bilodeau/ECE477PROJECTS/docs/FinalReport.tex

% just setup stuff
\documentclass[12pt]{article}

% Alter some LaTeX defaults for better treatment of figures:
    % See p.105 of "TeX Unbound" for suggested values.
    % See pp. 199-200 of Lamport's "LaTeX" book for details.
    %   General parameters, for ALL pages:
    \renewcommand{\topfraction}{0.9}	% max fraction of floats at top
    \renewcommand{\bottomfraction}{0.8}	% max fraction of floats at bottom
    %   Parameters for TEXT pages (not float pages):
    \setcounter{topnumber}{2}
    \setcounter{bottomnumber}{2}
    \setcounter{totalnumber}{4}     % 2 may work better
    \setcounter{dbltopnumber}{2}    % for 2-column pages
    \renewcommand{\dbltopfraction}{0.9}	% fit big float above 2-col. text
    \renewcommand{\textfraction}{0.07}	% allow minimal text w. figs
    %   Parameters for FLOAT pages (not text pages):
    \renewcommand{\floatpagefraction}{0.7}	% require fuller float pages
	% N.B.: floatpagefraction MUST be less than topfraction !!
    \renewcommand{\dblfloatpagefraction}{0.7}	% require fuller float pages

	% remember to use [htp] or [htpb] for placement

% style, margins, etc...
\usepackage[left=0.5in,top=1.5in,right=0.5in,bottom=1.5in]{geometry}
\usepackage{graphicx}
\usepackage{amsmath}
\usepackage{listings}
	\lstset{language = C}
\usepackage{url}
% all figures are stored in the subdir "figs"
\graphicspath{{./figs/}}

\newcommand{\tab}{\hspace*{2em}}

% define the title and author(s)
\author{Peter Bilodeau\\
	peterjbilodeau@gmail.com\and
	Brady Butler\\
	m.brady.butler@gmail.com\and
	Breanna Stanaway\and
	Cody Morgan\\
	}
\title{ECE 477 Final Project}

\begin{document}

%--------------------------------------------------------------------------
% generates the title
\maketitle

% abstract
\begin{abstract}
For this project, we designed and built an autonomous flying quadrotor.  Our design anticipates automatic stability control and navigation. This project lays the foundation for integrated sensor and motor control systems.
We built a custom aluminum frame and a custom electronic main board, and use stock hobby motors, propellers and lithium-polymer battery.
\end{abstract}
\clearpage

% start a new page
\clearpage

% generates the table of contents
%(need to run latex twice for this to get updated)
\tableofcontents

% start a new page
\clearpage

%--------------------------------------------------------------------------
% The Actual Paper

\input{flightdynamics}

\input{systemarchitecture}

\clearpage
\input{motorcontrol}

\clearpage
\input{power}

\input{communication}

\input{sensors}

\input{filtering}

\input{i2c}

\input{pidcontrollers}

\input{mastercontrol}

\clearpage
\input{pcside}

\clearpage
\input{partslist}

\clearpage
\input{schematics}

\clearpage
\input{code}

% The End
\end{document}
