bilodeau/ECE477PROJECTS/docs/schematics.tex

\section{Schematics}
\begin{figure}[htb]
\begin{center}
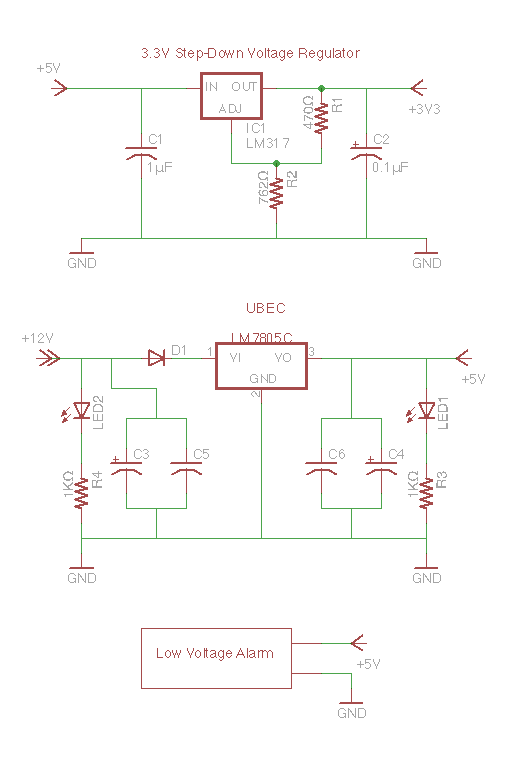
[picture p1: docs/powerschem.png]

\caption{Power Conversion Circuits}
\end{center}
\end{figure}

\begin{figure}[htb]
\begin{center}
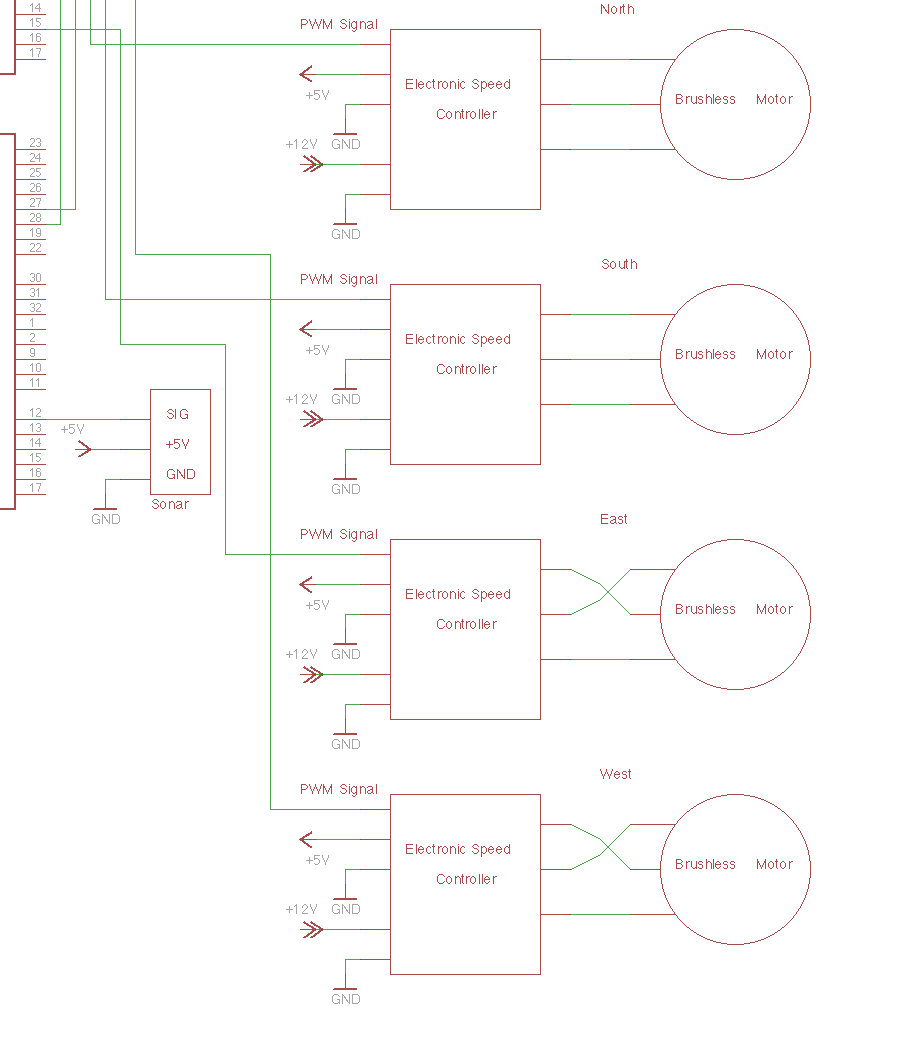
[picture p2: docs/motorsschem.png]

\caption{Motor Connections}
\end{center}
\end{figure}

\begin{figure}[htb]
\begin{center}
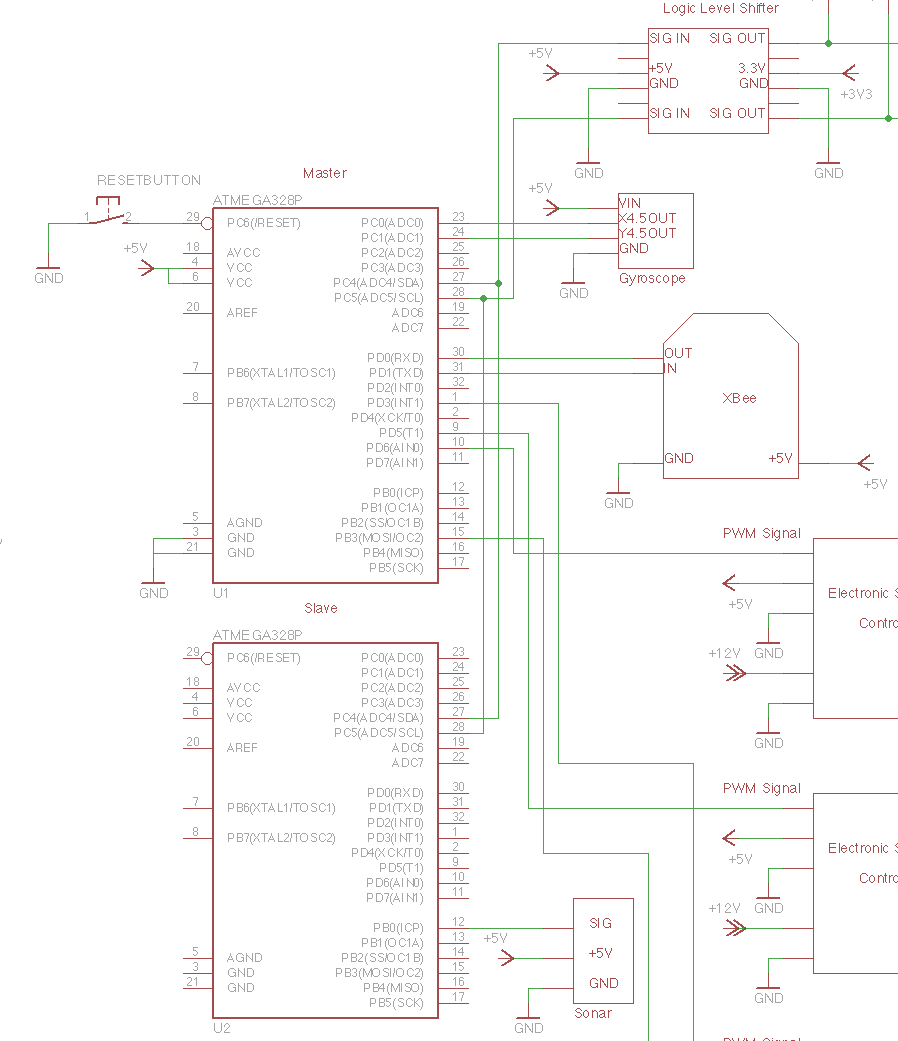
[picture p3: docs/masterslaveschem.png]

\caption{AVR Microcontroller Connections}
\end{center}
\end{figure}

\begin{figure}[htb]
\begin{center}
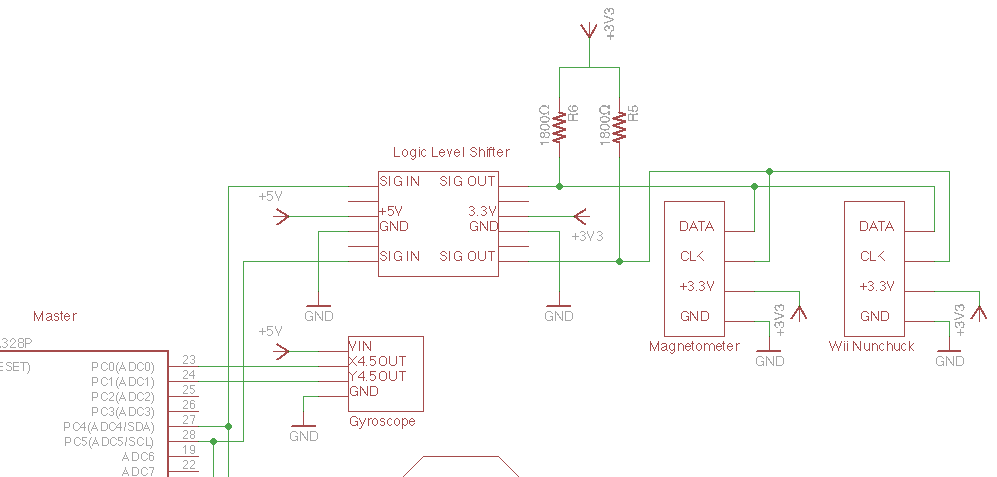
[picture p4: docs/i2cbusschem.png]

\caption{$I^2C$ Bus Circuit} 
\end{center}
\end{figure}
