bilodeau/ECE477PROJECTS/docs/partslist.tex

\section{Parts List}
\setcounter{table}{0}
\renewcommand*\thetable{\Alph{section}.\arabic{table}}
\begin{table}[htpb]
\begin{center}
\caption{Parts List}
\begin{tabular}{|l|l|r|r|}
\hline

Part & Make and Model & Quantity &Estimated Cost\\ \hline \hline 
Frame & 3/4" square aluminum tubing & 2 x 55cm & \$14.00\\ \hline
Motor &	Hextronik DT700 & 4 & 43.88\\ \hline
Propeller & 10x6 HCB & 4 & 3.48\\ \hline
Prop Saver & 4mm w/ Band & 4 & 4.18\\ \hline
ESC & HobbyWing Fly-Fun 18A Brushless ESC & 4 & 79.99\\ \hline
Battery & ZIPPY Flightmax 3000mAh 3S1P 20C & 1 & 12.99\\ \hline
Voltage Detector & Tunigy 3~8S Voltage Detector & 1 & 2.49\\ \hline
Power Distributer & custom & 1 & -\\ \hline
Sonar Sensor & Parallax Ping))) Ultrasonic & 1 & 29.99\\ \hline
Accelerometer & Wii Nunchuck & 1 & 19.99\\ \hline
Gyroscope & IDG500 Dual 500/s breakout & 1 & 39.95\\ \hline
Magnetometer & 3-Axis HMC5883L breakout & 1 & 14.95\\ \hline
UBEC & custom & 1 & -\\ \hline
5v to 3.3v converter & custom & 1 & -\\ \hline
Logic Level Converter & 1.8 to 5V range, BOB-08745& 1 & 1.95\\ \hline
Master / Slave controller & ATmega 328p & 2 & 9.90\\ \hline
XBee &  & 2 & 49.90\\ \hline
XBee adapter board & XBee to Serial & 2 & 33.90\\ \hline
Serial Port Adapter & Sheaf-Monk Utility Board & 1 & 10.00\\ \hline
Reset Button & Basic default-off push-buton & 1 & 0.50\\ \hline \hline
Total:&&& \$372.04\\ \hline
\end{tabular}
\end{center}
\end{table}
