bilodeau/ECE477PROJECTS/docs/TODO.txt

This document is intended to list the sections of the document which remain to be completed.

Breanna / Cody, I wasn't sure if you wanted your email addresses added to the cover page.  You can add them to FinalReport.tex if you want.

File that need writing:
FinalReport
mastercontrol
discussion
conclusion

Files completed up to proofreading or minor edits:
filtering
sensors
flightdynamics
systemarchitecture
motorcontrol
power
communication
I2C Bus
pidcontrollers
pcside
schematics
code
partslist
