bilodeau/ECE477PROJECTS/battleship/Serial.sch

## EAGLE design battleship/Serial.sch (2012-02-24, last stored version)

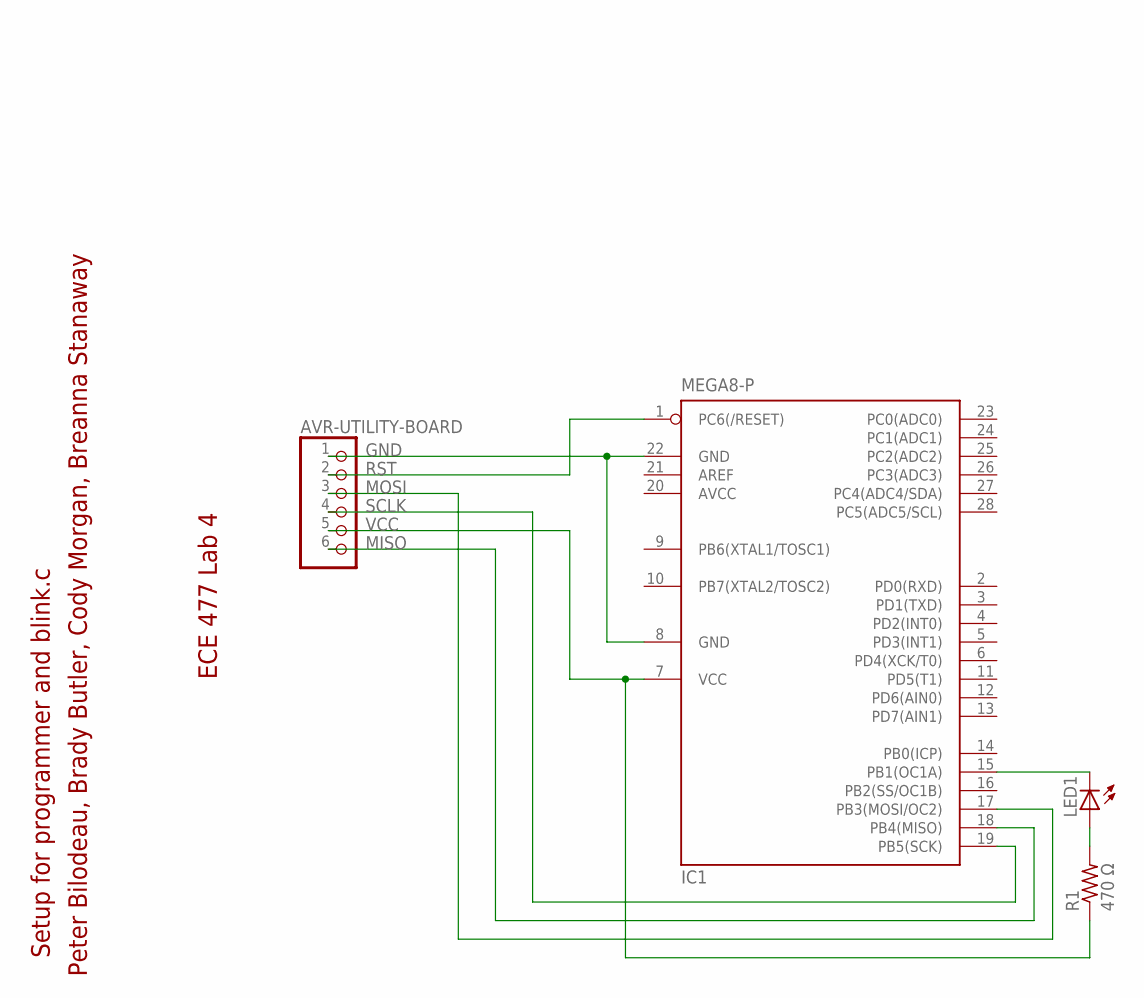
[picture p6: schematic Serial.sch]

Parts:
AVR-UTILITY-BOARD: PINHD-1X6; 1X06
IC1: MEGA8-P; DIL28-3
LED1: LED3MM
R1: 470 Ω; 0204V

Connections:
GND: AVR-UTILITY-BOARD.1, IC1.8 (GND), IC1.22 (GND)
MISO: AVR-UTILITY-BOARD.6, IC1.18 (PB4(MISO))
MOSI: AVR-UTILITY-BOARD.3, IC1.17 (PB3(MOSI/OC2))
unnamed: IC1.15 (PB1(OC1A)), LED1.K (C)
unnamed: LED1.A, R1.2
RST: AVR-UTILITY-BOARD.2, IC1.1 (PC6(/RESET))
SCLK: AVR-UTILITY-BOARD.4, IC1.19 (PB5(SCK))
VCC: AVR-UTILITY-BOARD.5, IC1.7 (VCC), R1.1

Notes on the sheet:
ECE 477 Lab 4
Peter Bilodeau, Brady Butler, Cody Morgan, Breanna Stanaway
Setup for programmer and blink.c
