bilodeau/ECE477PROJECTS/quadcopter/control/controller.h

#ifndef CONTROLLER_H_
#define CONTROLLER_H_
#include <avr/io.h>
#include <stdio.h>
#include "../lib/AVRserial.h"
#include "../lib/data.h"
#include "pidcontrol.h"
#include "../motors/motors.h"

#define ALT_P_GAIN 0//10
#define ALT_D_GAIN 0
#define ALT_GAIN_LIMIT 20

#define FLIP_P_GAIN 125
#define FLIP_D_GAIN 200
#define FLIP_GAIN_LIMIT 30

int base_thrust;

long controller_north_thrust;
long controller_south_thrust;
long controller_east_thrust;
long controller_west_thrust;

struct pid_values alt_control, roll_control, pitch_control;
struct goal_attrib target_state;

void query_cntrl_vals() {
        char temp[60];
	sprintf(temp, "alt Kp: %d, Kd: %d",alt_control.Kp, alt_control.Kd);
	transmit(temp);
	sprintf(temp, "flip Kp: %d, Kd: %d",roll_control.Kp, roll_control.Kd);
	transmit(temp);
}

void set_alt_controller_p(int i){
        alt_control.Kp = i;
}

void set_alt_controller_d(int i) {
        alt_control.Kd = i;

}
void set_flip_controller_p(int i){
        roll_control.Kp = i;
        pitch_control.Kp = i;
}

void set_flip_controller_d(int i) {
        pitch_control.Kd = i;
        roll_control.Kd = i;
}

void setup_target_state(){
	target_state.altitude = 0;
	target_state.pitch = 0;
	target_state.roll = 0;
	target_state.yaw = 0;
}

void set_base_thrust(int i){
	base_thrust = i;
	char temp[40];
	sprintf(temp,"new base: %d",base_thrust);
	transmit(temp);
}

void set_altitude(int alt){
	target_state.altitude = alt;
	char temp[40];
	sprintf(temp,"new alt: %d",target_state.altitude);
	transmit(temp);
}

void setup_controller(){
	setup_target_state();
	set_attrib(&alt_control, ALT_P_GAIN, ALT_D_GAIN, ALT_GAIN_LIMIT);
	set_attrib(&roll_control, FLIP_P_GAIN, FLIP_D_GAIN, FLIP_GAIN_LIMIT);
	set_attrib(&pitch_control, FLIP_P_GAIN, FLIP_D_GAIN, FLIP_GAIN_LIMIT);	
}

void compute_controller(){
	sensor_data_cache.alt_gain = get_gain(&alt_control, target_state.altitude, sensor_data_cache.filt_altitude);
	sensor_data_cache.roll_gain = get_gain(&roll_control, target_state.roll, sensor_data_cache.filt_roll_angle);
	sensor_data_cache.pitch_gain = get_gain(&pitch_control, target_state.pitch, sensor_data_cache.filt_pitch_angle);

	controller_north_thrust = base_thrust + sensor_data_cache.alt_gain + sensor_data_cache.pitch_gain; 
	controller_south_thrust = base_thrust + sensor_data_cache.alt_gain - sensor_data_cache.pitch_gain;
	controller_east_thrust = base_thrust + sensor_data_cache.alt_gain + sensor_data_cache.roll_gain;
	controller_west_thrust = base_thrust + sensor_data_cache.alt_gain - sensor_data_cache.roll_gain;
	if (controller_north_thrust > MAXIMUMSIGNAL) {
		controller_north_thrust = MAXIMUMSIGNAL;
	} else if (controller_north_thrust < IDLESIGNAL) {
		controller_north_thrust = IDLESIGNAL;
	}
	if (controller_south_thrust > MAXIMUMSIGNAL) {
		controller_south_thrust = MAXIMUMSIGNAL;
	} else if (controller_south_thrust < IDLESIGNAL) {
		controller_south_thrust = IDLESIGNAL;
	}
	if (controller_east_thrust > MAXIMUMSIGNAL) {
		controller_east_thrust = MAXIMUMSIGNAL;
	} else if (controller_east_thrust < IDLESIGNAL) {
		controller_east_thrust = IDLESIGNAL;
	}
	if (controller_west_thrust > MAXIMUMSIGNAL) {
		controller_west_thrust = MAXIMUMSIGNAL;
	} else if (controller_west_thrust < IDLESIGNAL) {
		controller_west_thrust = IDLESIGNAL;
	}

	// turn off north and south rotors for testing roll
	controller_north_thrust = MINIMUMSIGNAL;
	controller_south_thrust = MINIMUMSIGNAL;
}

void update_motors(){
	compute_controller();
	set_motor_power(NORTHMOTOR,controller_north_thrust);
	set_motor_power(SOUTHMOTOR,controller_south_thrust);
	set_motor_power(EASTMOTOR,controller_east_thrust);
	set_motor_power(WESTMOTOR,controller_west_thrust);
}
#endif
