bilodeau/ECE477PROJECTS/quadcopter/control/pidcontrol.h

#ifndef PIDCONTROL_H_
#define PIDCONTROL_H_

struct pid_values{
int Kp; //constants for the pid controllers
int Kd;
int old_error; //the old error value
int gain_limit; // gain output is forced into the interval [-limit,limit]
};


struct goal_attrib{ //what we want all of the sensor data to be to have a certain mode. 
int yaw;
int pitch;
int altitude;
int roll;
};

void set_attrib(struct pid_values *s, int p, int d, int limit) {
	s->Kp = p;
	s->Kd = d;
	s->old_error = 0;
	s->gain_limit = limit;
}

int get_gain(struct pid_values *s, int goal, int actual){
	int error = goal - actual;

	int derivative = error - s->old_error;
	s->old_error = error;
	int gain = (s->Kp)/1000.*error + (s->Kd)/1000.*derivative;
//	int oldgain = gain;
	if(gain > s->gain_limit){
		gain = s->gain_limit;
	}else if(gain < -1*(s->gain_limit)){
		gain =  -1*(s->gain_limit);
	}else if (gain == 0){
		if(error>0){
			gain = 1;
		}else if(error<0){
			gain = -1;
		}
	}
/*	char temp[100];
	sprintf(temp,"deriv: %d",derivative);
	transmit(temp);
*/
	return gain;
}
#endif
