bilodeau/ECE477PROJECTS/serial/rtttl_modular.h

#include <stdio.h>
#include <string.h>
#include <ctype.h>
#include <math.h>
#include <stdlib.h>
#include <termios.h>
#include <unistd.h>
#include <fcntl.h>
#include "rtttl.h"

#define DEBUG 0
#define DDURATION 4
#define DOCTAVE 6
#define DBPM 63

struct note* get_note_array(int *bpm, int *num_notes);
char* parse_note_string(char* ptr,struct defaults* defs, struct note* n);
void parse_defaults(char* defaultsstring, struct defaults* defs);
void parse_s_def(char *ptr, struct defaults *def);
int calc_divisor(char *pitch_string, char *octave_string);
int calc_cycles(struct defaults* defs, char* len_string, char* dot);
int convert(int key);
void playthesong();
char* get_len();
char* get_pitch();
char* get_octave();
char* get_dot();
char *break_up_string(char *ptr, char *defs);
int count_notes(char song[], char c);
char *clear_space(char *ptr);
int isEmpty(char* ptr);
void error(char* errorcode);

// returns an array of note structs corresponding to the notes of Haunted House.
// takes pointers to variables for bpm and number of notes and fills them
// with the proper vaalues.
struct note* get_note_array(int *bpm, int *num_notes) {
  char song[] = "HauntedHouse: d=4,o=5,b=120: 2a4, 2e, 2d#, 2b4, 2a4, 2c, 2d, 2a#4, 2e., e, 1f4, 1a4, 1d#, 2e., d, 2c., b4, 1a4, 1p, 2a4, 2e, 2d#, 2b4, 2a4, 2c, 2d, 2a#4, 2e., e, 1f4, 1a4, 1d#, 2e., d, 2c., b4, 1a4";
  char *defaultsstring, *tune;
  struct defaults defs;

  defaultsstring = malloc(strlen(song) + 1);    // allocate memory for the defaults section of the string
  if (defaultsstring == NULL){error("Out of memory.");}

  tune = break_up_string(song, defaultsstring);		// break up song into its 3 parts.

  parse_defaults(defaultsstring,&defs);			// parse default string into default struct

  int count = count_notes(tune, ','); // get number of notes
  struct note* notes = malloc(sizeof(struct note)*count); // allocate memory for notes

  int i = 0;
  char *currentNote = tune;				// while there are notes in the note section, parse them into the array
  while(!isEmpty(currentNote)){
    if (i >= count) {error("Bad Note Section.");}
    currentNote = parse_note_string(currentNote, &defs, &notes[i]);
    i++;
  }

  *bpm = defs.bpm;  // assign proper bpm
  *num_notes = i;   // assign proper number of notes

  free(defaultsstring); // free memory
  return notes; // return note struct array
}

// counts the number of commas in the song section and returns the count + 1
// # notes = # commas + 1 ; except when there are no notes
int count_notes(char song[], char c) {
  int count = 0;
  int i;
  for (i = 0; i < strlen(song); i++)
    if (song[i] == c)
      count++;
  return count + 1;
}

// given a ptr to a RTTTL string, parse the defaults section into defs
// and return a pointer to the notes section
// IMPORTANT: defs must have already had memory allocated to it or Seg Fault will occur
char *break_up_string(char *ptr, char *defs) {
  char *defsstr, *tune;

  defsstr = strchr(ptr, ':') + 1; // advance ptr beyond first ':'
  tune = strchr(defsstr, ':') + 1;  // advance ptr beyond second ':'

  sscanf(defsstr, "%[^:]", defs); // parse defaults

  return tune;  // return ptr to the "tune" section opf the RTTTL string
}

// advances a char ptr to the next character in the string that isn't white space
// returns the new ptr
char *clear_space(char *ptr) {
  char* dummy = malloc(strlen(ptr) + 1);  // allocate memory
  dummy[0] = '\0';  // set delimiter
  sscanf(ptr,"%[ ]",dummy); // scan all chars that are white space and put into dummy buffer
  ptr += strlen(dummy); // advance pointer the length of "dummy"
  free(dummy);
  return ptr; // return new ptr
}

// parse defaults values into a defaults struct
void parse_defaults(char *ptr, struct defaults *def) {

  // Establish default values

  ptr = clear_space(ptr);		// advance ptr through empty space

  def->len = DDURATION;		// establish default duration
  def->bpm = DBPM;        // establish default bpm
  def->oct = DOCTAVE;     // establish default octave

  char *temp = malloc(strlen(ptr) + 1);		// temp var to hold scanned items

  sscanf(ptr, "%[^,]", temp);	// scan first item and parse
  parse_s_def(temp, def);     // parse a single element of the defaults section

  while ((ptr = strchr(ptr, ',')) != NULL) {	// while there are more defaults, scan them and parse
    ptr += 1;   // increment ptr since it is currently pointing at ','
    sscanf(ptr, "%[^,]", temp);   // scan up to next ','
    parse_s_def(temp, def);       // parse the scanned single element
  }

  free (temp);		// free memory
}

// parses a given char ptr as a type of default assignment and places it into the
// specified defaults struct
void parse_s_def(char *ptr, struct defaults *def) {

  ptr = clear_space(ptr); // clear any white space

  char *temp = malloc(strlen(ptr) + 1);   // allocate var to hold
  if (temp == NULL){error("Out of memory.");}   // check for Out of Memory

  if (sscanf(ptr, "%[^=]", temp) > 1) {error("Bad Defaults String.");}  // scan up to '='

  *temp = toupper(*temp);   // capitalize temp to simplify case checking

  // check if char is equal to one of the value octave categories. return Bad if not.
  if (*temp == 'D') {
    ptr = strchr(ptr, '=') + 1;   // advance pointed beyond '='
    sscanf(ptr, "%d", &(def->len)); // scan decimal value at ptr into the len of defs
  } else if (*temp == 'B') {
    ptr = strchr(ptr, '=') + 1;   // advance pointed beyond '='
    sscanf(ptr, "%d", &(def->bpm)); // scan decimal value at ptr into the bpm of defs
  } else if (*temp =='O') {
    ptr = strchr(ptr, '=') + 1;  // advance pointed beyond '='
    sscanf(ptr, "%d", &(def->oct)); // scan decimal value at ptr into the oct of defs
  }
  else {
    error("Bad Default Identifier.");
  }

  free(temp);
}


char *parse_note_string(char *ptr, struct defaults *def, struct note *note){
  char len_string[3];
  char pitch_string[3];
  char octave_string[2];
  char dot[2];

  // eat whitespace / commas and advance the pointer
  char* dummy = malloc(strlen(ptr)+1);
  if (dummy == NULL){ error("malloc failed");}
  dummy[0] = '\0';
  sscanf(ptr,"%[ ,]",dummy);
  ptr += strlen(dummy);
  free(dummy);

  DEBUG&&printf("Begin Parsing Note String...\n");
  ptr = get_len(ptr, len_string, def->len);
  DEBUG&&printf("get_len Successful...\n");
  ptr = get_pitch(ptr, pitch_string);
  DEBUG&&printf("get_pitch Successful...\n");
  ptr = get_octave(ptr, octave_string, def->oct);
  DEBUG&&printf("get_octave Successful...\n");
  ptr = get_dot(ptr, dot);
  DEBUG&&printf("get_dot Successful...\n");

  strcpy(note->pitch, pitch_string);
  sscanf(len_string, "%d", &(note->length));
  sscanf(octave_string, "%d", &(note->octave));

  note->divisor = calc_divisor(pitch_string, octave_string);
  DEBUG&&printf("divisor successful\n");

  note->cycles = calc_cycles(def, len_string, dot);
  DEBUG&&printf("cycles successful\n");

  return ptr;
}


int isEmpty(char* ptr){
  return (ptr[-1] == '\0')||!(strlen(ptr)>0);
}
void error(char* errorcode){
  printf("Exiting with error code: %s\n",errorcode);
  exit(1);
}

char *get_len(char *ptr, char *len_string, int dur) {

  if ((dur > 32) || (dur < 1)){
    error("Bad Note Duration.");
  }

  char *temp;
  temp = malloc(strlen(ptr) + 1);

  if (temp == NULL){
    error("Out of memory.");
  }

  sprintf(temp, "%d", dur);

  if (sscanf(ptr, "%[0123456789]", temp)) {
    if (strlen(temp) > 2) {
      error("Bad Note Duration.");
    } else {
      ptr += strlen(temp);
    }
  }
  strcpy(len_string, temp);

  free(temp);
  return ptr;
}


char *get_pitch(char *ptr, char *pitch_string) {

  char *temp;
  temp = malloc(strlen(ptr) + 1);

  if (temp == NULL){error("malloc failed in get_pitch.");}

  if (!sscanf(ptr, "%[ABCDEFGPabcdefgp#]", temp)){
    error("Bad Pitch.");
  }

  if (strlen(temp) > 2) {error("Bad Pitch.");}

  strcpy(pitch_string, temp);
  ptr += strlen(temp);
  free(temp);
  return ptr;
}

char *get_octave(char *ptr, char *octave_string, int oct) {

  char *temp;
  temp = malloc(strlen(ptr) + 1);

  if (temp == NULL){error("malloc failed in get_octave.");}
  if ((oct > 7) || (oct < 4)){error("Specified Octave out of range. Too High.");}

  sprintf(temp, "%d", oct);

  if(sscanf(ptr, "%[4567]", temp)) {
    if (strlen(temp) > 1) {
      error("Bad Octave.");
    } else {
      strcpy(octave_string, temp);
      ptr += strlen(temp);
    }
  }

  free(temp);
  return ptr;
}

char *get_dot(char *ptr, char *dot) {

  char *temp;
  temp = malloc(strlen(ptr) + 1);

  if (temp == NULL){error("malloc failed in get_dot");}

  if(sscanf(ptr, "%[.]", temp)) {
    if (strlen(temp) > 1) {
      error("Illegal character after \".\".");
    } else {
      strcpy(dot, temp);
      ptr += strlen(temp);
      //printf("%s\n",dot);
    }
  }else{ // there was no dot so write something else into *dot
    sprintf(dot,"%d",0);
  }

  free(temp);
  return ptr;
}

int calc_divisor(char *pitch_string, char *octave_string) {

  int oct;
  sscanf(octave_string, "%d", &oct);

  float div = convert(toupper(*pitch_string));
  float mod = 1;
  if (strlen(pitch_string) > 1) {

    if (pitch_string[1] == '#') {
      mod = 0.943874313;
    } else { // otherwise flat
      mod = 1.05946309;
    }
  }

  div *= pow(2, (4 - oct));
  div *= mod;

  return (int)div;
}

int convert(int key){
  switch (key){
  case 'C': return 4560;
  case 'D': return 4063;
  case 'E': return 3619;
  case 'F': return 3416;
  case 'G': return 3043;
  case 'A': return 2711;
  case 'B': return 2415;
  case 'P': return 0;
  default: return -1;
  }
}

// returns the duration of the note in microseconds
int calc_cycles(struct defaults *defs, char *len_string, char *dot){
  int duration;

  if (sscanf(len_string,"%d",&duration) != 1){error("Bad Duration");}

  duration = (defs->len*60*1000000)/defs->bpm / duration;

  if (*dot == '.'){
    duration *= 1.5,DEBUG&&printf("DOT\n");
  }else{
    DEBUG&&printf("NODOT\n");
  }
  return duration;
}
