bilodeau/ECE477PROJECTS/(commit log)

2012-02-19 send / receive w/o interrupts
2012-02-20 new serial device IDs
2012-02-22 serials to header and corrected baud
    [AVRserial.h, baud.h]
2012-02-22 changed calculation of LED position from (i*4 + j) to (i + j*4)
2012-02-22 fixed indentation of main() function. created setup_interrupt() to initialize interrupt
2012-02-24 started schematic and final project writeup
    [Serial.sch]
2012-02-24 added battleship game animations
    [Serial.sch]
2012-02-28 i2c bus working with magnetometer
2012-02-29 i2c refactor plus some reorganization
2012-02-29 added Brady's barometer code, temp / press not working yet.
    [barometer.h]
2012-02-29 added Brady's barometer code, temp / pressure not working yet
2012-02-29 barometer and magnetometer working on the same bus
2012-02-29 added query_true_value() function to get actual temperature and pressure data
2012-03-04 added motors / gyro directories
2012-03-05 added PCstatus, which add realtime device monitoring
2012-03-06 cleaned up pressure calculation function
2012-03-21 started i2c slave
2012-03-23 working motors code
2012-03-28 motor control with new ESCs plus close-to-working slave
2012-04-02 fixed delay function, simple nunchuck-feedback control
    [motors.c, motors.h, nunchuck.h]
2012-04-05 created AVRircapture.c and setup the interrupts therein
2012-04-05 made the OCR1A val double the divisor so that it only gets called when a full period is missed
    [AVRircapture.c]
2012-04-05 interrupt for COMPB is enbaled now
2012-04-07 fixed master control flow
    [master.c]
2012-04-07 fixed motors.c
2012-04-08 tweaked motor control values
2012-04-09 created new fifo queue structure for sensor_data along with methods to manipulate it
2012-04-09 motors changes plus cleaning up device polling
2012-04-09 added filtering scheme
2012-04-09 added functions to update adjusted roll, pitch, and altitude
2012-04-09 changed master control flow to have multiple frequency interrupts
2012-04-10 code reorganization plus new magnetometer correction function
    [demo.c, master.c, slave.c]
2012-04-11 reduced spam frequency, nunchuck still gives some read address send failures
    [UI.h, i2c.h, master.c, test.c]
2012-04-13 added extra error messages in I2C read function to catch the read address error we have been having
    [i2c.h]
2012-04-13 I2C read error now results in a Stop Condition being sent to reset the line
    [i2c.h]
2012-04-18 added ADC lab part A, R code need writing
2012-04-18 fixed plot generation (can use "make plot") and added fan control code
    [AVRadc.c, fan.h]
2012-04-20 working ADC lab part A
2012-04-22 switched to free running mode on the ADC
2012-04-22 some adc comments
2012-04-27 added motor control waveforms
2012-04-30 report update, plus added some graphics / schematics
2012-05-01 added i2c section
2012-05-02 sensor section pushed. I totally committed and forgot to push last night.
2012-05-02 updated data filtering
2012-05-02 added sensors and filtering
